sbis04/plant_intelligence/docs/plant-intelligence-wiring.pdf

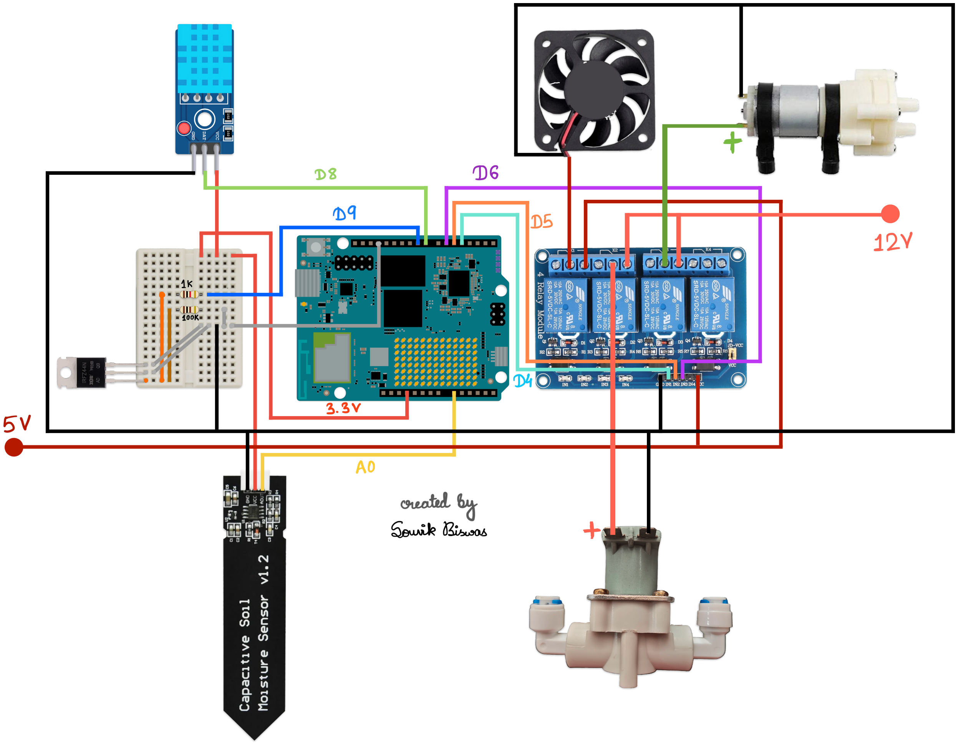
[picture p7: page 1]
