sbis04/plant_intelligence/docs/img/wiring.png

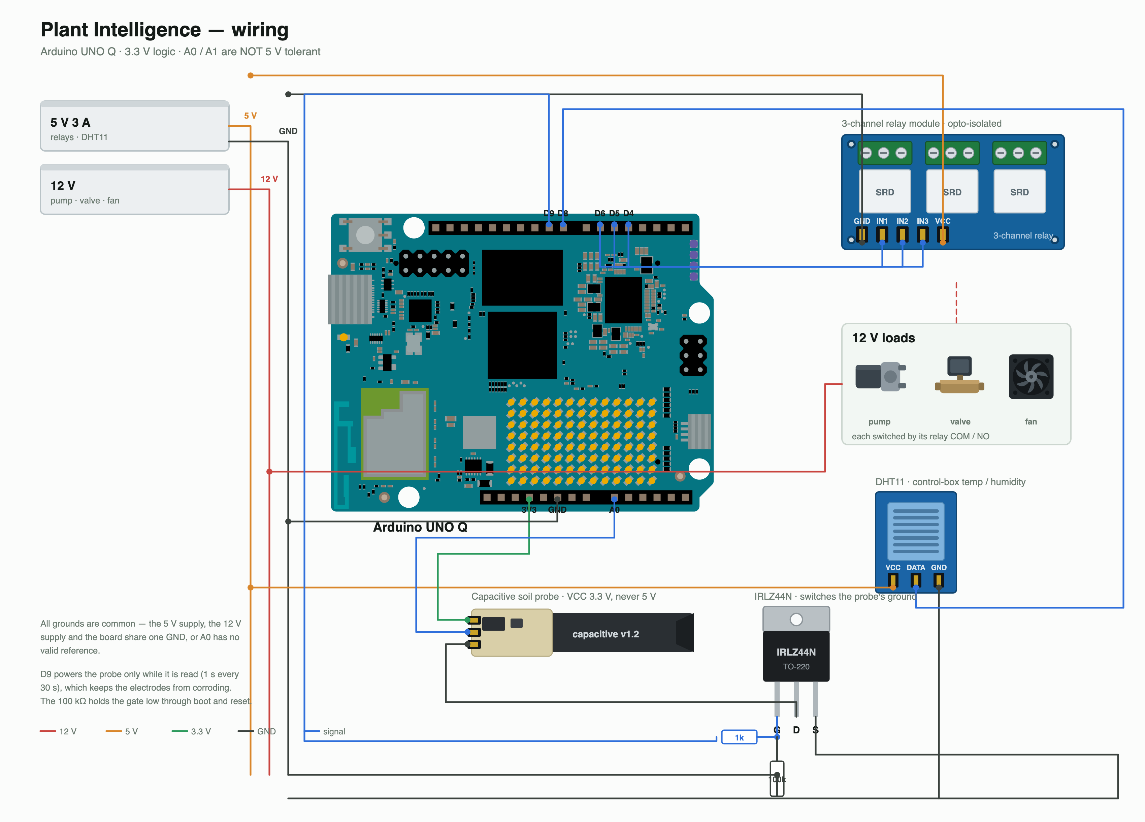
docs/img/wiring.png
