sbis04/plant_intelligence/(commit log)

2026-08-09 Fix failsafe false trigger caused by ping race in loop
    [sketch.ino]
2026-08-09 Expose location, outside conditions and fan state in API
2026-08-09 Report DHT failure once per episode, with recovery event
    [sketch.ino]
2026-08-09 Keep repeating DHT failure logs, add recovery marker
    [sketch.ino]
2026-08-09 Add on-board LLM assistant grounded in live system data
2026-08-09 Add LED matrix animations: boot sprout, watering rain, idle heartbeat
2026-08-09 Add native iOS app: garden, on-device assistant, activity, settings
2026-08-09 Add streaming chat and device stats endpoints, harden stream recovery
2026-08-09 Stream replies in dashboard, add device stats footer, simplify location line
2026-08-09 Report DHT failures once per episode
    [sketch.ino]
2026-08-09 Add garden camera snapshots from RTSP with dashboard and app cards
2026-08-09 Rework garden header and hero, fix camera card lifecycle, dismiss keyboard on tap
2026-08-09 Move camera under the hero and render it full bleed
2026-08-09 Add full screen camera viewer with landscape toggle
2026-08-09 Add camera lightbox on dashboard and slow ambient polling
2026-08-09 Stream live camera feed to the full screen viewers
2026-08-09 Play the live stream in the iOS camera viewer
2026-08-09 Rename the app to Plants and allow landscape for the camera viewer
2026-08-09 Turn the assistant tab button into close while the overlay is open
2026-08-09 Raise stream quality, cap fps, and open the web dialog on the last frame
2026-08-09 Add a stop button for running assistant replies
2026-08-09 Route assistant to Gemini Flash when online with on-device fallback
2026-08-09 Give the assistant eyes via the garden camera
2026-08-09 Relay the camera's native stream as HLS for full quality live view
2026-08-09 Play the HLS live stream in the app camera viewer
2026-08-09 Persist assistant conversations as threads on the hub
2026-08-09 Cut assistant latency with minimal thinking and photo attachments
2026-08-09 Redesign the dashboard composer with attachments and live backend chip
2026-08-09 Add photo attachments, fix tab layouts and viewer auto-rotate
2026-08-09 Persist and render photo attachments in threads
2026-08-09 Shrink attached photos to thumbnails in the transcript
2026-08-09 Keep attachment thumbnails small without cropping
2026-08-09 Round the thumbnail image itself, not its frame
2026-08-09 Make Water now a translucent water-blue glass button
2026-08-09 Deepen the glass blur on the water button
2026-08-09 Use an inline bar for native edge blur and thin the button material
2026-08-09 Light up the board: matrix modes, RGB status LEDs, mDNS default
2026-08-09 Keep the matrix dark at idle to spare the LEDs
2026-08-09 Swap thinking sparkles for a sweeping pulse
    [sketch.ino]
2026-08-09 Give the boot sprout a layered soil bed
2026-08-15 Sample the DHT frame with interrupts off
2026-08-15 Water on fixed 7 AM and 5 PM slots until the soil probe is in
2026-08-15 Show the fixed slots instead of a cadence the engine isn't using
2026-08-15 Keep the fixed-slot dose flat at 5 minutes
2026-08-16 Let the camera judge the weather instead of the forecast
2026-08-16 Drop dashes from the camera status lines
2026-08-16 Check the camera just before a watering, and start it on time
2026-08-16 Tell an uncalibrated probe apart from a missing one
2026-08-16 Let the camera view zoom and pan
2026-08-16 Let camera gestures pass over live video
2026-08-17 Open the full system log with a time filter
2026-08-17 Tidy the log dialog scrollbar and filter chips
2026-08-17 Stop the global button flex stretching small text buttons
2026-08-17 Let the camera fill the landscape safe area
2026-08-18 Keep a stalled weather call from freezing the scheduler
2026-08-20 Widen the soil scale so afternoon drift cannot release the brake
2026-08-20 Only stretch the cadence for rain the camera hasn't refuted
2026-08-21 Give the soil probe time to settle and shorten the cadence
    [sketch.ino]
2026-08-23 Add the wiring diagram
2026-08-23 Draw the wiring diagram with real component artwork
2026-08-25 Notice when the board stops accepting commands
2026-08-30 Move the wet anchor below what the probe actually reaches
2026-09-08 Restart the hub when the MCU stops accepting commands
    The Bridge has twice gone one-way: telemetry keeps arriving, so the board
    looks healthy, while every outbound command is dropped. The hub cannot
    water, the MCU's dead-man timer expires, and it waters on its own failsafe
    every 14 hours until someone notices. The second occurrence ran 57 hours.
    A restart clears it every time, but arduino-app-cli lives outside the
    container the app runs in, so the app cannot restart itself. A host-side
    cron watchdog polls the status endpoint and restarts after ten minutes of
    failed commands, deferring while a watering is in progress and rate-limited
    to one restart per half hour.
2026-09-08 Remote access: Firestore mirror, command queue, automatic pairing
    The system stays local-first — SQLite is the source of truth and the app
    talks straight to the hub whenever it can see it. This adds the mirror for
    when it cannot.
    Hub side (hub/python/cloud.py) reaches Firestore over REST rather than the
    Python SDK: grpc and its dependency tree is a lot to carry for half a dozen
    HTTP calls a minute. It publishes device_state/current — the same payload
    /api/status returns, so nothing above the transport has to know which path
    the data came by — drains water_history and system_logs from the `synced`
    outbox that was already in the schema, and polls a commands collection.
    Two failure mode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
2026-09-08 Correct the deploy commands: the board has no rsync, and --delete would take data/
    data/ holds config.json and plant.db on the board and is empty in the repo,
    so the documented rsync --delete would have deleted the credentials and the
    entire watering history on the first run. The board turns out not to have
    rsync at all, so the working instruction is scp per directory.
2026-09-08 Keep the Firebase project id out of the system log and status payload
    The log is on screen in the dashboard and in the app, so anything written
    to it ends up in screenshots. An account identifier has no business being
    there — 'Firestore sync configured' says everything a reader needs, and
    whether the mirror is connected is already its own field.
    The two rows that had already been written were rewritten in place, in
    SQLite on the board and in the mirrored system_logs documents. Those
    documents deny delete by design, being an append-only record, so the
    message field was patched rather than the row removed.
2026-09-08 Restrict Firestore to an allowlist of accounts
    The rules said 'request.auth != null', which sounds like a lock and is not
    one. The Web API key ships inside the app binary and is trivially extracted,
    and the project accepts public email/password sign-ups — so anyone who
    unzipped the app could mint an account and had full read/write on every
    collection.
    This was not theoretical. A throwaway account created with the app's own key
    read device_state/current and successfully queued a watering command. It is
    now denied on every collection, verified the same way.
    Access is an allowlist of the five accounts that actually exist. Adding a
    household member is a deliberate edit here, which is the poi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
2026-09-10 Keep the soil-block timer across restarts
    The 48-hour cap exists to catch a probe that reads wet forever while the
    garden quietly dries out — believe the sensor, but not indefinitely. It
    could never fire. The start time lived only in memory, so every restart set
    the clock back to zero, and with the MCU watchdog able to restart the hub on
    its own, a run long enough to trip the cap was effectively unreachable.
    The timestamp now lives in the database, alongside a companion reading that
    records when the run was last actually observed. Continuity has to be proven
    rather than assumed: if nothing looked at the soil for longer than a restart
    takes, the wet run is not claimed across the gap and th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
2026-09-10 Report the camera going away once, not twice an hour
    A camera that is off, unplugged, or has had its local stream taken away is a
    standing condition, not thirty fresh incidents a day. The log said so every
    thirty minutes, in red, which is how entries that genuinely need attention
    end up buried under text nobody reads any more.
    It now reports the transition — once when the camera goes, once when it
    comes back — the way the MCU link already does.
